MiniVoitz/AES128_SV/CR_AES128.pdf

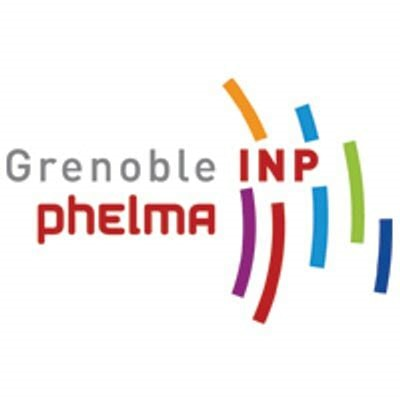
[picture p1: figure]

École Nationale Supérieure de Physique,

# Électronique et Matériaux

## Compte Rendu Mini-Projet AES128

DEVILLARD Hugo - VOITZWINKLER Tom

5 mai 2024

### Table des matières

1 Introduction | 3
2 Architecture | 3
3 RTL | 5
4 Simulation fonctionnelle | 5
5 Synthèse logique | 6
6 Simulation post-synthèse | 7
7 Placement-routage | 8
8 Simulation post-layout | 10
9 Améliorations possibles | 10
10 Conclusion | 10
Bibliographie | 11
Annexes | 11

PHELMA | AES128

### 1 Introduction

Le chiffrement est un élément crucial de la sécurité des données dans de nombreux domaines. L’algorithme de chiffrement avancé AES (Advanced Encryption Standard) est devenu l’un des algorithmes les plus utilisés pour assurer la confidentialité et la sécurité des données. Dans ce rapport, nous présentons notre compte rendu de mini-projet portant sur l’implémentation matérielle de l’algorithme de chiffrement AES128.

L’objectif de ce projet était de concevoir et de simuler une architecture matérielle efficace et optimisée pour le chiffrement et le déchiffrement de données selon la norme AES128. Nous avons choisi de développer cette architecture en utilisant le langage de description matériel SystemVerilog et nous avons réalisé plusieurs étapes allant de la spécification de l’algorithme à la simulation post-layout.

### 2 Architecture

Pour notre architecture nous avons choisi d’utiliser le standard AES128 défini dans [3]. L’algorithme de chiffrement se compose de deux parties principales :

- La génération des clés successives (RoundKey) à partir de la clé initiale : KeyExpansion
- Les différentes étapes du processus de chiffrement : SubBytes, ShiftRows, MixColumns et AddRound-Key. Le standard prévoit de faire 10 tours de boucle (RoundBlock) dans le cas d’AES128.

Le message et la clé sont représentés sous la forme d’une matrice 4x4 avec 16 coefficients qui représentent chacun 8 bits.
Détail de chaque bloc :
- SubBytes : Ce bloc permet de substituer des groupes de 8 bits selon la matrice définie dans le standard.
Nous fournissons en annexe la table utilisée pour la substitution.

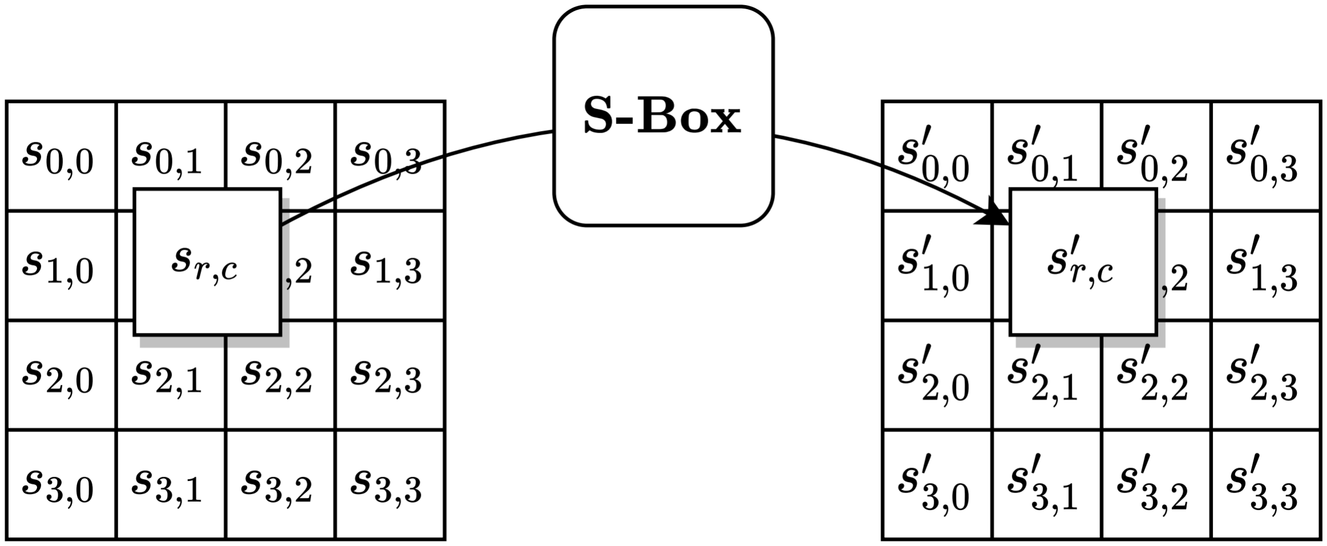
[picture p2: figure]

FIGURE 1 – Illustration de SubBytes

- ShiftRows : Permet d’effectuer une permutation circulaire sur une ligne de la matrice.

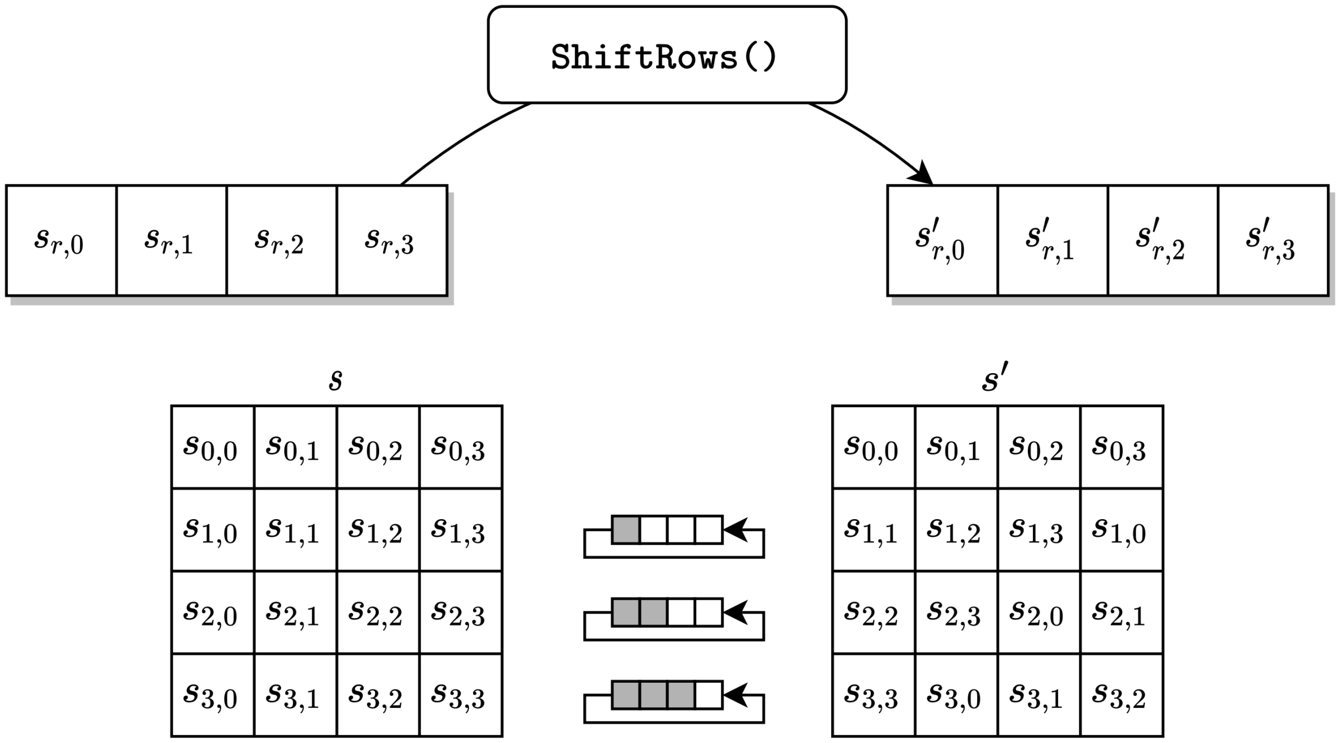
[picture p3: figure]

FIGURE 2 – Illustration de ShiftRows

La première ligne ne subit pas de permutation, la deuxième subit une seule permutation, la troisième deux et la dernière trois.

- MixColumns : Chaque colonne de la matrice est multipliée par une autre matrice qui contient les coefficients d’un polynôme dans le domaine de Galois.

Il est intéressant de noter ici que l’on effectue des multiplications modulaires ainsi lorsque l’on multiplie un coefficient par 2, cela revient à faire l’opération suivante : Soit x un coefficient de la matrice initiale.

- Si le bit de poids fort est 1 alors : le résultat de la multiplication par 2 est ((x « 1) XOR 00011011)
- Sinon le résultat est x « 1

De plus, multiplier par 3 revient à multiplier par 2 et réaliser un XOR avec la valeur initiale.

FIGURE 3 – Multiplication d’une colonne par le polynôme de Galois correspondant

- AddRoundKey : consiste en un XOR entre la matrice en cours et la RoundKey (addition dans le domaine de Galois)

3

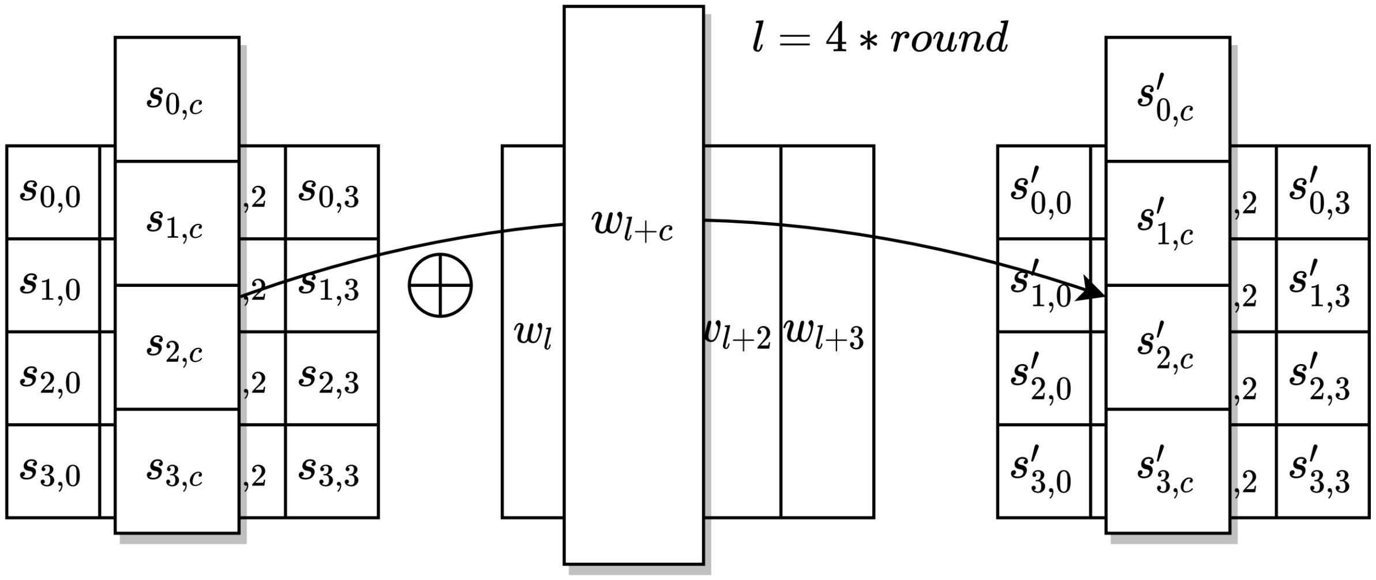
[picture p4: figure]

FIGURE 4 – XOR entre la matrice et la RoundKey

- KeyExpansion : permet de générer les 10 clés successives nécessaires à chaque tour dans la boucle de chiffrement. L’algorithme est fourni en annexe. Le terme Rcon dans l’algorithme correspond à une constante fixée pour chaque round.

### 2.1 Première version : chiffrement

Dans cette première version nous nous sommes concentrés sur la partie chiffrement. Nous obtenons alors l’architecture suivante :

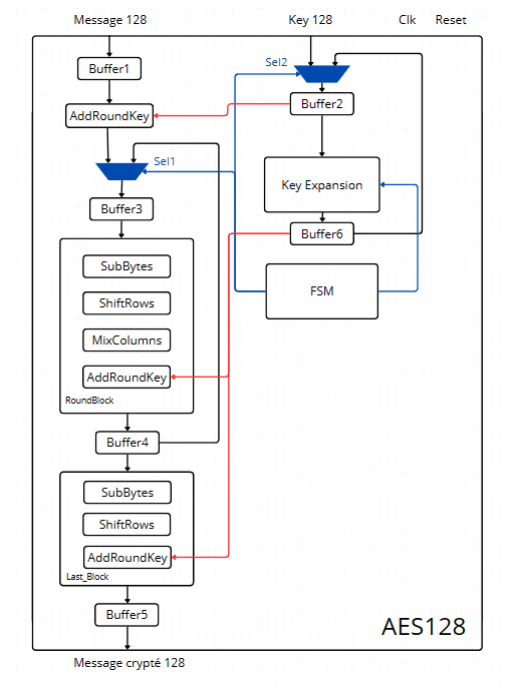
[picture p5: figure]

FIGURE 5 – Architecture choisie pour le chiffrement

Dans ce modèle, nous avons réalisé une approche pipeline en séparant par des registres les différents grands blocs qui composent notre module de chiffrement. De plus, il est à noter que la génération des RoundKey se fait au cours du chiffrement. Ainsi ces clés ne sont pas stockées, ce qui permet de diminuer le nombre de registres.

### 2.2 Deuxième version : Chiffrement et déchif-

frement

Nous avons dans un second temps décidé d’ajouter un module de déchiffrement. Cependant il est n’est plus possible de générer en cours de déchiffrement les Round-Key puisque cela signifierait d’effectuer 10! générations de RoundKey. En effet, nous avons besoin pour le déchiffrement d’avoir accès à la RoundKey numéro 10 en première clé. Cette RoundKey ce génère à partir de la 9

me RoundKey qui elle-même est générée à partir de la 8... La complexité augmente rapidement. C’est pourquoi nous avons choisi de stocker les 11 clés (10 RoundKey + 1 Key) qui permettent le chiffrement et le déchiffrement du message. Le fait de stocker ces clés augmente toutefois le nombre de registres. Nous obtenons alors l’architecture suivante :

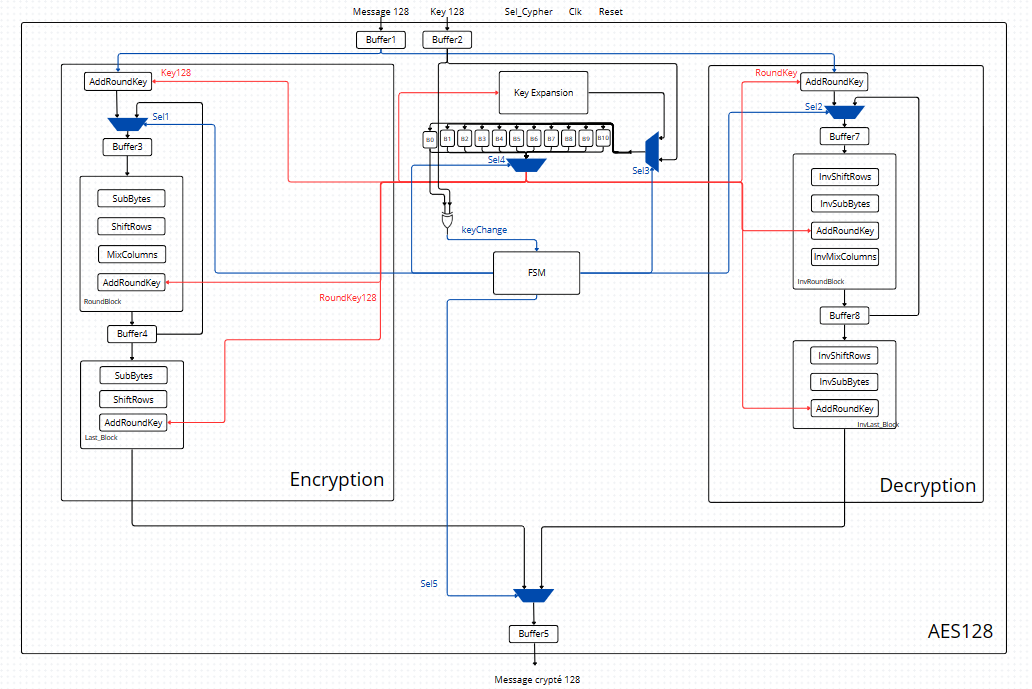
[picture p6: figure]

FIGURE 6 – Architecture choisie qui permet le chiffrement et le déchiffrement

Nous avons de plus ajouté une comparaison entre la clé d’entrée et celle stockée dans le registre nommé B0. Cette comparaison permet de chiffrer/déchiffrer plusieurs messages de suite avec la même clé sans avoir à régénérer toutes les RoundKey.

### 2.3 Troisième version : Module complet avec in-

terface de communication

Comme notre système comportait un grand nombre de pins (128 pour le message, 128 pour la clé, 128 pour le message chiffré et quelques pins de contrôle), il était nécessaire de créer une interface de communication. Nous nous sommes alors inspirés du bus APB [1]. Nous proposons alors une interface de communication permettant d’envoyer et de recevoir les informations par salves de 32 bits à l’aide de quelques signaux de contrôle :

- Initiate : permet de lancer la communication en passant à l’un des états de lecture/écriture.
- Data : Bus de données.

4

- R/W : Permet de choisir si on veut lire ou écrire les données sur les registres du module.
- Address : Permet de choisir si on souhaite écrire le message ou la clé (0 : message, 1 : clé)
- SelCypher : Permet de choisir si on veut chiffrer ou déchiffrer le message envoyé. (1 : chiffrement, 0 : déchiffrement)
- Start : Permet de lancer le calcul. Nous n’avons pas lancé le calcul immédiatement après réception des données pour simplifier notre FSM d’interface.
- CS : Un signal permet de déconnecter le registre de sortie (en état haute impédance) tant que la fsm d’interface n’est pas dans l’état d’envoi du résultat sur le bus.

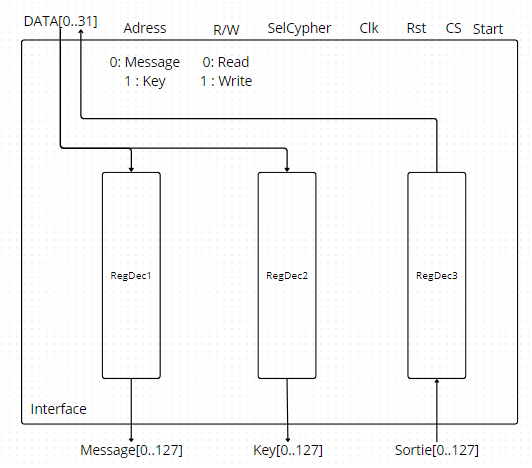
[picture p7: figure]

FIGURE 7 – Interface de communication entre le bus et le module AES

En réalité, dans le coeur de notre circuit, nous avons utilisé deux bus de données data_in et data_out : un pour l’entrée et l’autre pour la sortie ainsi qu’un signal CS qui est relié à chaque plot correspondant au bus. En effet, cela nous permet d’utiliser un plot de type BBT16P qui utilise une porte à trois états pour se déconnecter du bus :

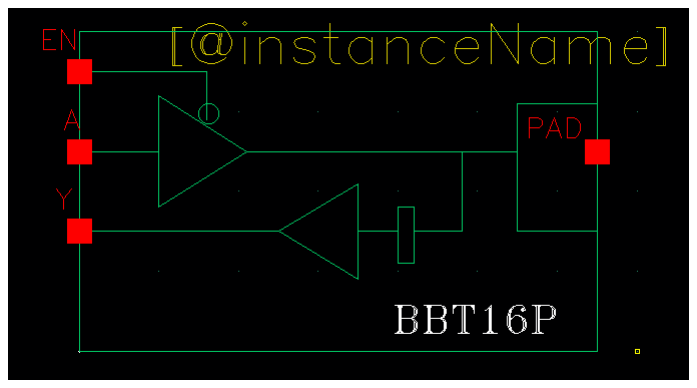
[picture p8: figure]

FIGURE 8 – Vue schematic du plot BBT16P

Le schéma complet de l’architecture réalisée est présent en annexe.

Avec cette architecture, nous nous attendons donc à retrouver :

- Les registres de stockage des RoundKey : 11 × 128 = 1408 registres
- Les registres de l’interface : 3×128 = 384 registres
- Les registres présents entre les étapes de l’algorithme : 7 × 128 = 896 registres
- Les registres d’états des deux fsm : 7 registres.

Au total, notre architecture compte donc : 2695 registres.

### 3 RTL

Nous avons codé notre module de chiffrement en System Verilog. L’ensemble de notre code ainsi que les testbench est disponible sur le répertoire Github Cliquer ICI. (https://github.com/MiniVoitz/AES128_SV) Nous fournissons également les fichiers .do permettant d’avoir un affichage plus lisible des signaux sur Model-Sim. Il est à noter que nous avons vérifié toutes les erreurs de syntaxe ainsi que les potentiels latch inference à l’aide du module LINT de Spyglass. Le répertoire git présente plusieurs branches avec le code pour la simulation fonctionnelle, le code après synthèse et le code après placement-routage.

### 4 Simulation fonctionnelle

On réalise ensuite, par l’intermédiaire de ModelSim, des simulations de chaque sous-bloc de notre module ainsi que de notre module entier. Là encore les testbenchs sont présents sur le répertoire Github Cliquer ICI. (https://github.com/MiniVoitz/AES128_SV)
La complexité de l’algorithme fait que si l’un des sous blocs crée un bit erroné le message crypté final aura presque 50% de bits erroné. Un test validé signifie qu’il est peu probable que notre module fonctionne par chance. De plus de nombreux logiciels qui permettent de chiffrer/déchiffrer un message sont disponibles en ligne, ce qui nous a permis de tester aisément le bon fonctionnement de notre module.
Prenons par exemple la simulation de notre bloc au complet et testons de chiffrer puis de déchiffrer le message :

5

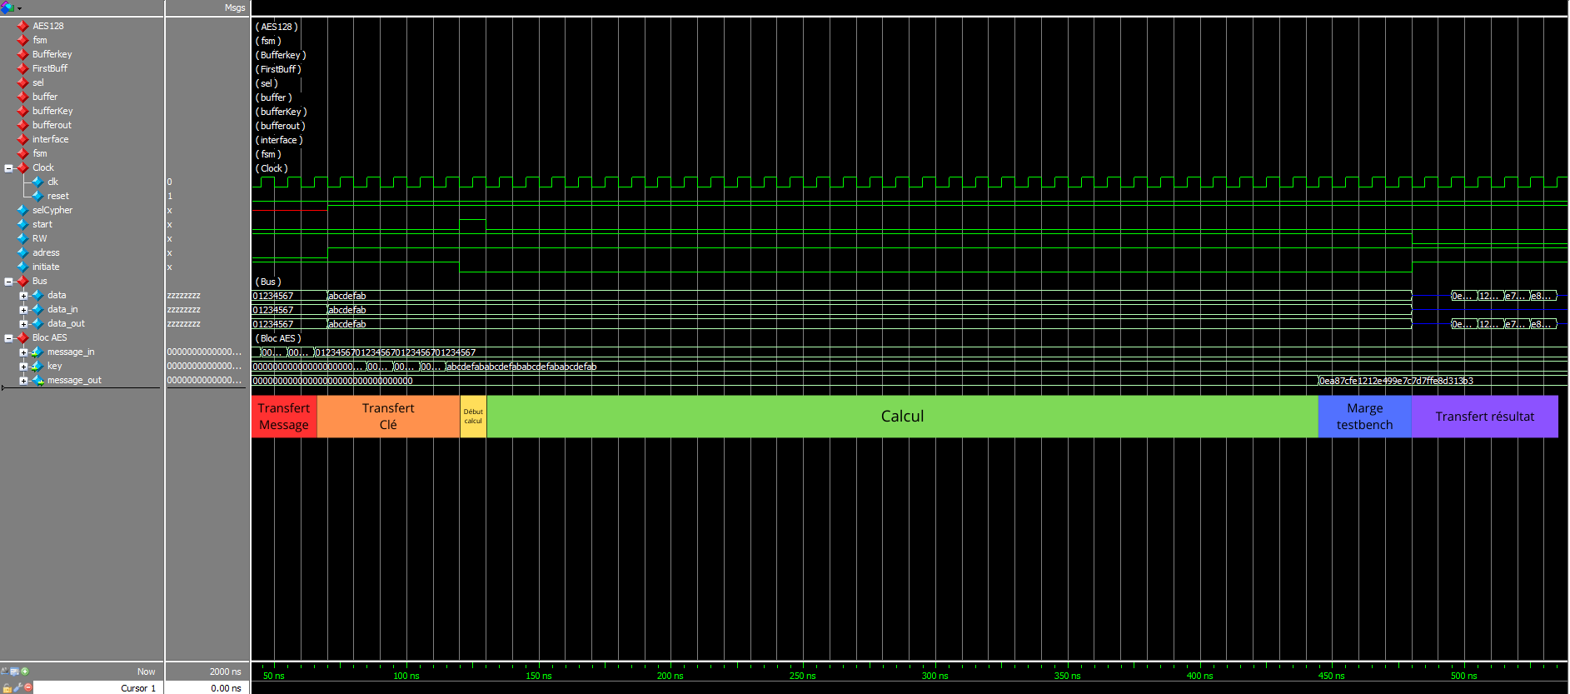
[picture p9: figure]

FIGURE 9 – Chiffrement d’un message

Le résultat est bien celui qui est attendu, comme le montre le calculateur utilisant l’algorithme que l’on cherche à implémenter :

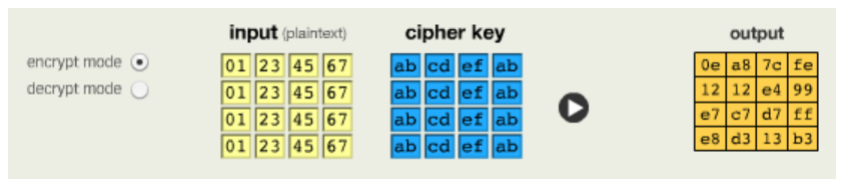
[picture p10: figure]

FIGURE 10 – Résultat du chiffrement

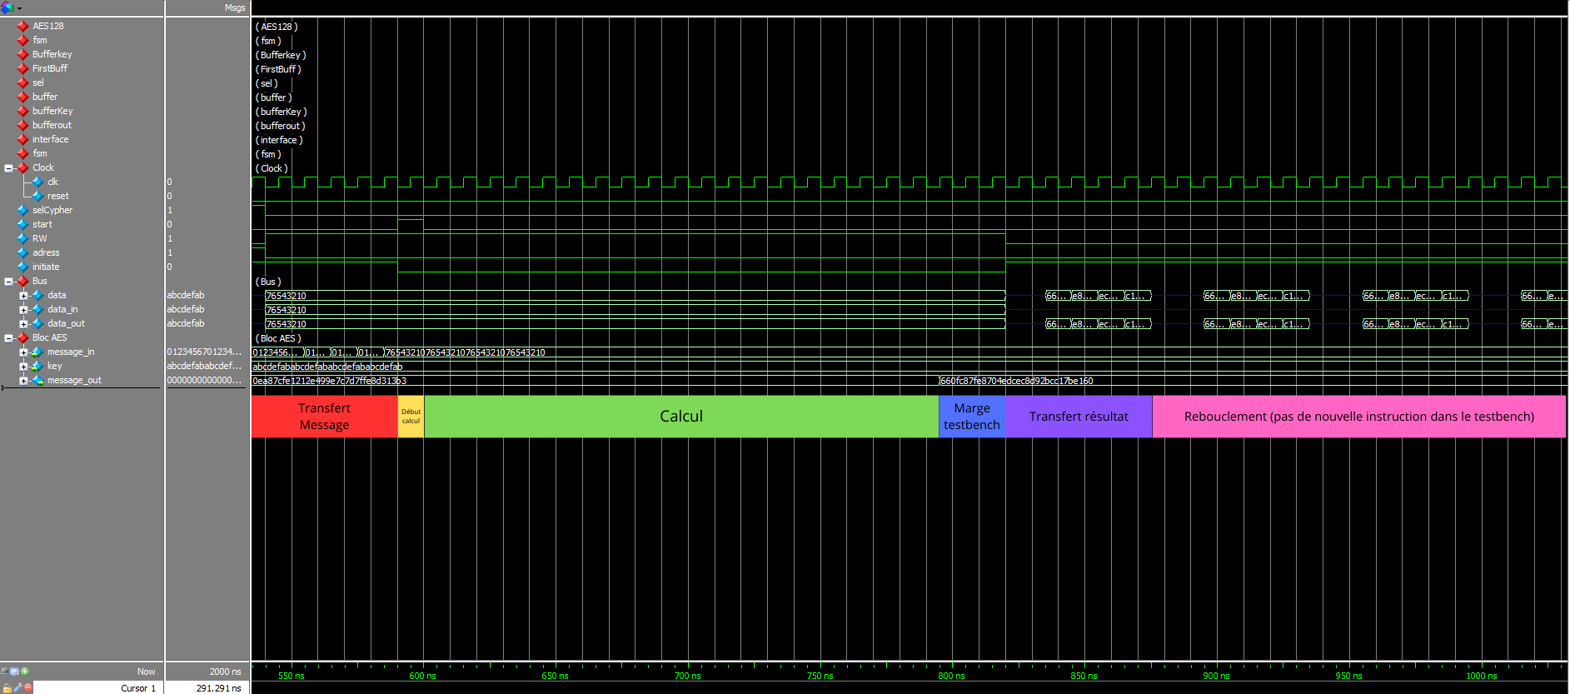
[picture p11: figure]

FIGURE 11 – Déchiffrement d’un message

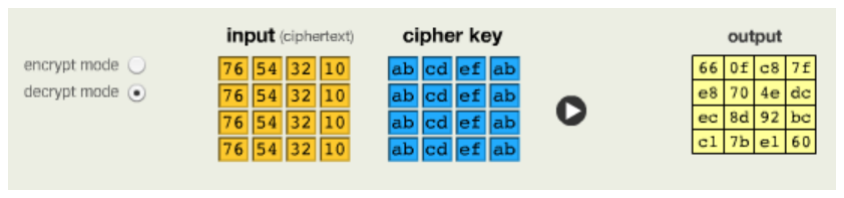
[picture p12: figure]

FIGURE 12 – Résultat du déchiffrement

On note qu’il n’a pas été nécessaire de retransmettre la clé de chiffrement entre les deux étapes. Cette fonctionnalité nous a paru pertinente du fait que AES128 est un chiffrement symétrique donc la clé est la même pour le chiffrement et le déchiffrement. On peut ainsi éviter le chemin critique imposé par la génération des RoundKey et ainsi gagner du temps sur la phase de calcul.

### 5 Synthèse logique

On cherche à présent à traduire la description fonctionnelle du circuit en une représentation logique qui sera implémentée sous forme de portes logiques et de bascules génériques. Pour cela, nous utilisons DesignVision. L’objectif de cette partie est dans un premier temps, la vérification de la cohérence de notre module i.e. s’assurer que la conception répond bien aux spécifications fonctionnelles du circuit. Puis nous nous intéresserons à l’étude du chemin critique, la détermination d’une fréquence d’horloge valide, l’estimation de la consommation et de la surface. De plus cette synthèse nous permet de vérifier une seconde fois la bonne réalisation de notre module en étudiant le nombre de registres alloués. Comme il n’y avait pas de contraintes sur les performances du circuit final, nous choisissons une approche qui n’optimise aucun paramètre en particulier.

### 5.1 Étude du chemin critique

En testant les limites de notre module on remarque que pour une fréquence d’horloge idéale de 8 ns on obtient un bon fonctionnement du circuit si la réponse de chaque bloc est inférieur à 7.82 ns, ce qui est tout juste le cas :

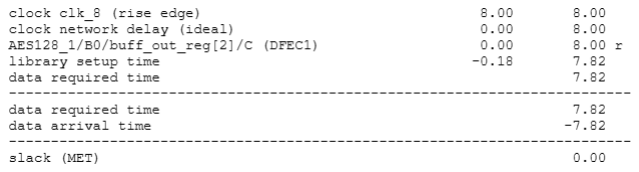
[picture p13: figure]

FIGURE 13 – Rapport du chemin critique par Design Vision pour TCLK = 8ns

Le logiciel de synthèse permet également d’obtenir une répartition des chemins prenant le plus de temps dans le circuit. Pour cela, il additionne le temps propre à chaque porte logique pour chaque chemin possible et en déduit ainsi le chemin critique.
Puisque nous n’avions pas de cahier des charges nous avons choisi une période d’horloge de 10 ns pour les prochaines études ainsi que pour la génération de la netlist. Dans ce cas nous observons la répartition suivante des chemins critiques :

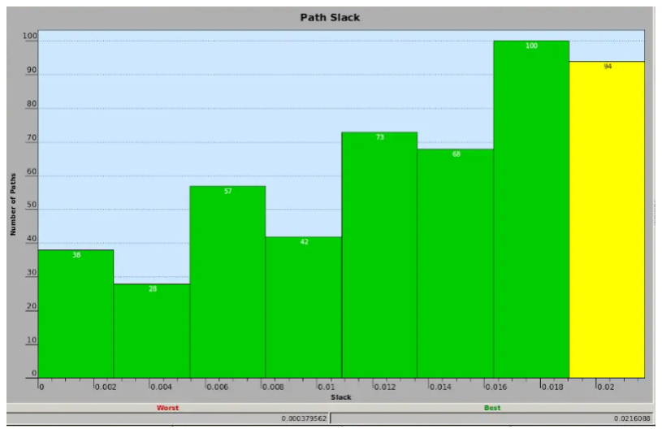
[picture p14: figure]

FIGURE 14 – Répartition des différents temps de réponse

Nous remarquons alors que le chemin critique se trouve lors de la génération des RoundKey.

6

Il pourrait être intéressant de comparer le temps lié au passage dans RoundKey et de le comparer avec l’écart obtenu lors de la simulation avec réutilisation de la clé pour voir si notre architecture permet effectivement de gagner du temps en stockant toutes les clés successives.

### 5.2 Étude de la surface

Pour ce qui est de l’étude de la surface occupée par notre circuit, nous avons utilisé les fonctionnalités de synthèse de Design Vision pour estimer la taille occupée par notre conception sur la puce. Cette surface n’est pas représentative du circuit final puisque la surface estimée par DesignVision ne tient pas compte des contraintes de placement routage et de géométrie mais se contente d’additionner les surfaces de toutes les portes logiques utilisées. À une fréquence d’horloge de 10 ns, la synthèse nous indique que la surface totale occupée par notre circuit est d’environ 4.8mm²

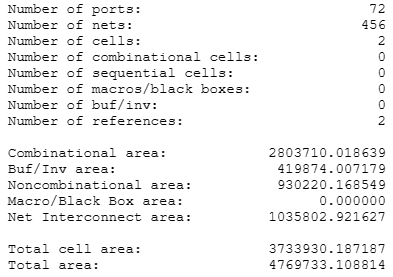
[picture p15: figure]

FIGURE 15 – Rapport de la surface totale de la synthèse

FIGURE 16 – Détail de la surface du module complet

On remarque que la surface est avant tout limitée par la présence d’un grand nombre de registres, à l’aide des des outils de DesignVision, nous avons pu vérifier que la synthèse avait bien le même nombre de registres que notre architecture.

### 5.3 Étude de la consommation

Finalement on s’intéresse à la consommation de notre circuit. Design Vision nous permet d’obtenir une estimation de la puissance de notre module. Le logiciel additionne ainsi les consommations statique et dynamique de chaque porte logique mais ne prend pas en compte les éléments ajoutés lors du placement routage comme la consommation de l’arbre d’horloge, des interconnexions, des plots et des fillers entre les cellules. Un extrait du rapport est disponible ci-dessous.

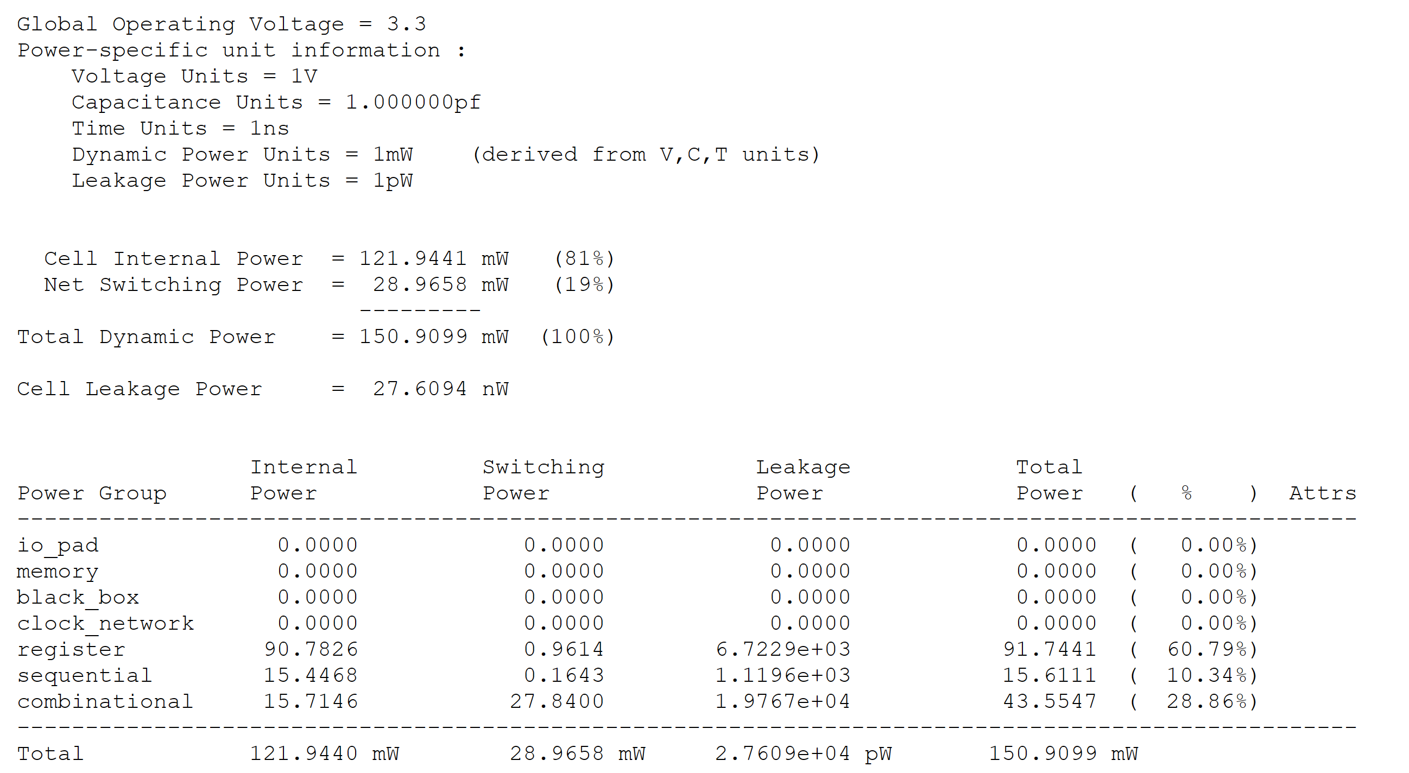
[picture p16: figure]

FIGURE 17 – Estimation de la consommation

A nouveau nous n’avions pas de cahier des charges, cette étude nous permet donc uniquement d’obtenir une idée de la consommation. Nous n’avons pas cherché à optimiser ce paramètre. On peut toutefois noter que la majeur partie de la consommation est liée aux registres utilisés : si on veut réduire la puissance consommée, il faut ainsi réduire le nombre de registres.

A la fin de la synthèse logique nous disposons d’une netlist verilog contenant les portes logiques génériques utilisées pour notre circuit ainsi qu’une estimation du délai dans chaque chemin réalisé par STA (static timing analysis) dans un fichier sdf.

### 6 Simulation post-synthèse

Après avoir effectué la synthèse logique, qui consiste à traduire la description fonctionnelle du circuit en une représentation logique, la simulation post-synthèse permet de vérifier le comportement fonctionnel et chronologique du circuit synthétisé.

Le testbench nommé : Puce_sans_plot_tb.sv permet la vérification du bon fonctionnement de notre module de chiffrement après la synthèse logique.

Nous illustrons ici deux exemples prenant en compte le fichier SDF (si on zoomait sur la figure, on pourrait observer les décalages temporels induits par les retards dans les portes logiques) :

7

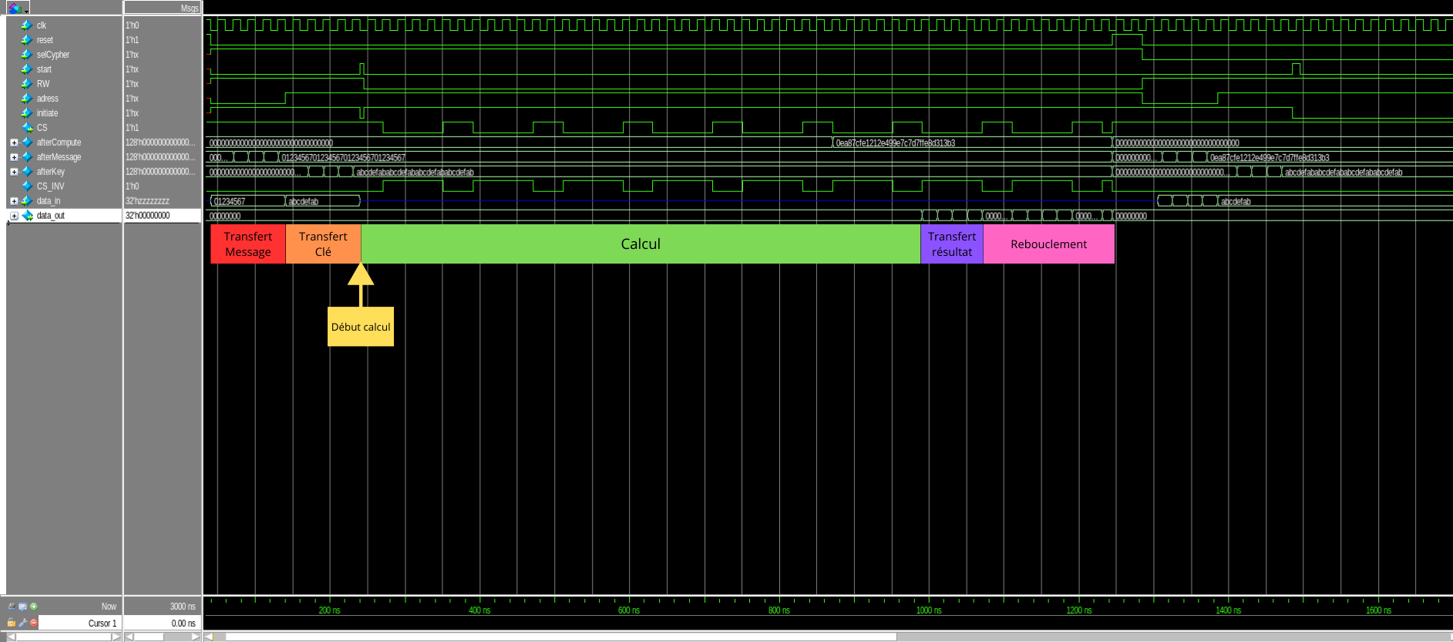
[picture p17: figure]

FIGURE 18 – Simulation d’un chiffrement post-Synthèse avec prise en compte du fichier SDF

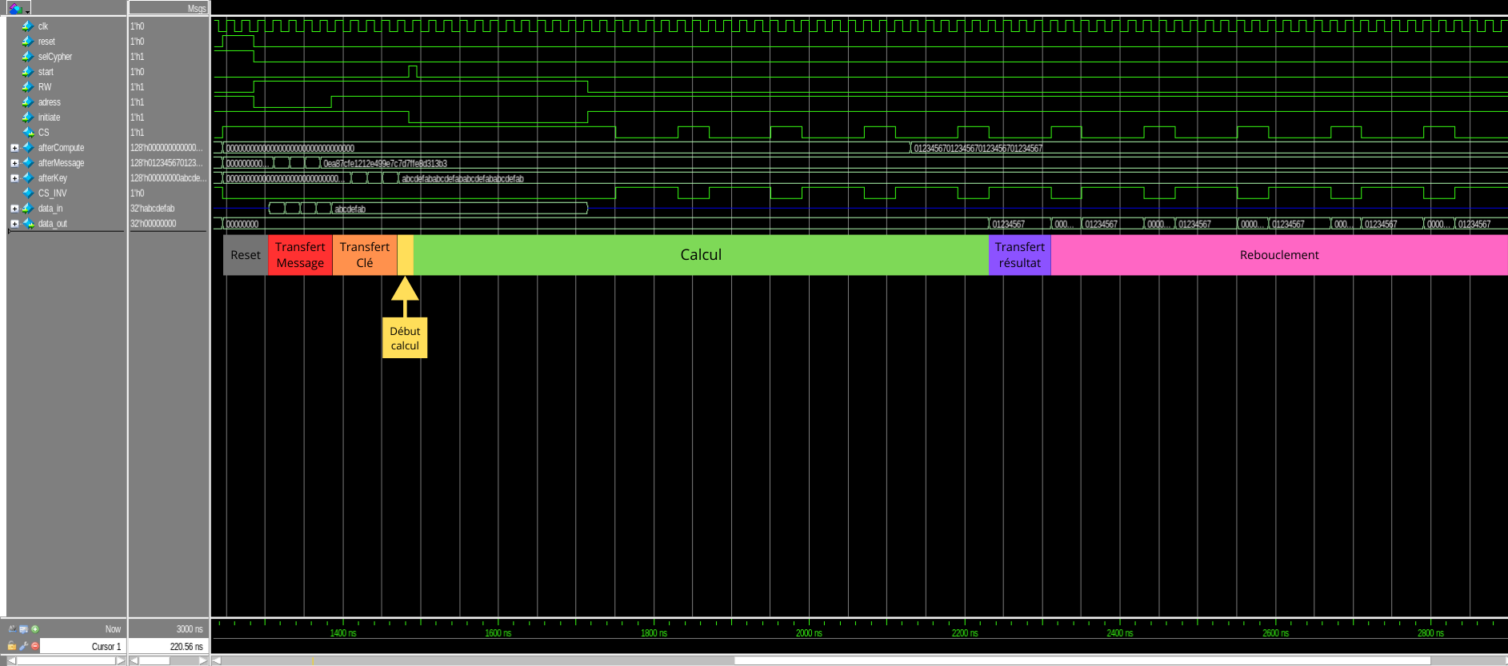
[picture p18: figure]

FIGURE 19 – Déchiffrement post-Synthèse avec fichier SDF

Nous avons vérifié dans les deux cas la valeur retournée par notre module à l’aide du calculateur cité en bibliographie. La phase de rebouclement est simplement due à notre testbench qui permet de renvoyer le plus tôt possible la valeur calculée.

### 7 Placement-routage

Nous avons ensuite procédé à l’étape de Placement-Routage de notre circuit en utilisant l’outil Innovus. Cette étape consiste à mapper la conception logique du circuit sur la surface physique de la puce, en assignant des positions physiques à chaque élément du circuit. C’est ici que l’on définit les contraintes physiques de notre circuit :

- Position des plots
- Ring et Stripes pour l’alimentation
- Définition de l’arbre d’horloge
- Choix de la taille du coeur

Pour simplifier la conception, nous avons réalisé les étapes à l’aide de l’interface graphique puis nous avons copié les commandes qui nous convenaient dans le script init.tcl d’Innovus.
Comme indiqué dans le TP Filtre, il faut prendre des pistes de l’ordre de 1 µm par mA pour les rings d’alimentation : or d’après le rapport DesignVision, notre circuit consomme presque 50 mA, c’est pourquoi nous avons choisi des pistes de 50 µm de large.
Nous avons choisi de mettre 5 stripes pour éviter les zones de chutes de tension dues aux pertes linéiques.

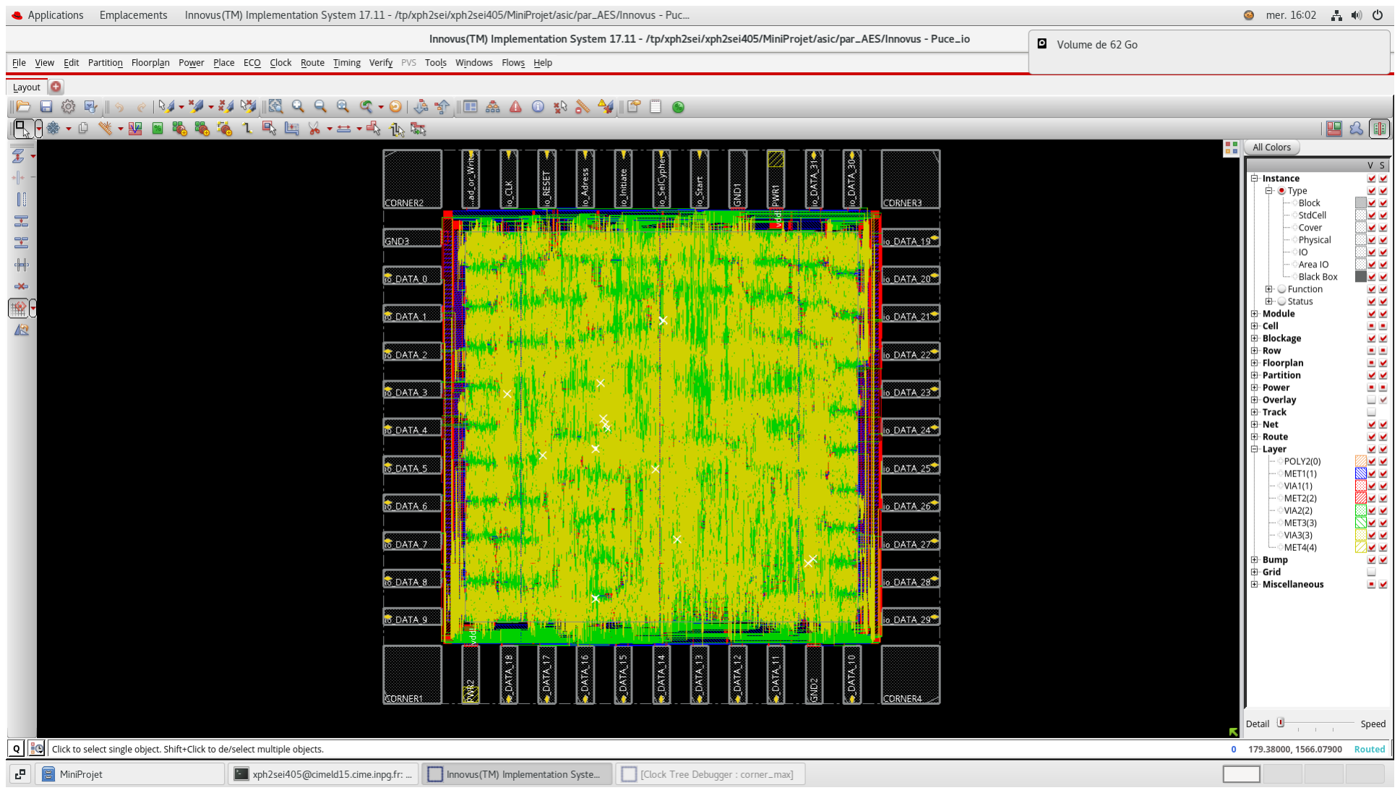
[picture p19: figure]

FIGURE 20 – Layout final après placement-routage

Il reste quelques erreurs liées aux contraintes du fondeur mais qui pourraient être résolues.

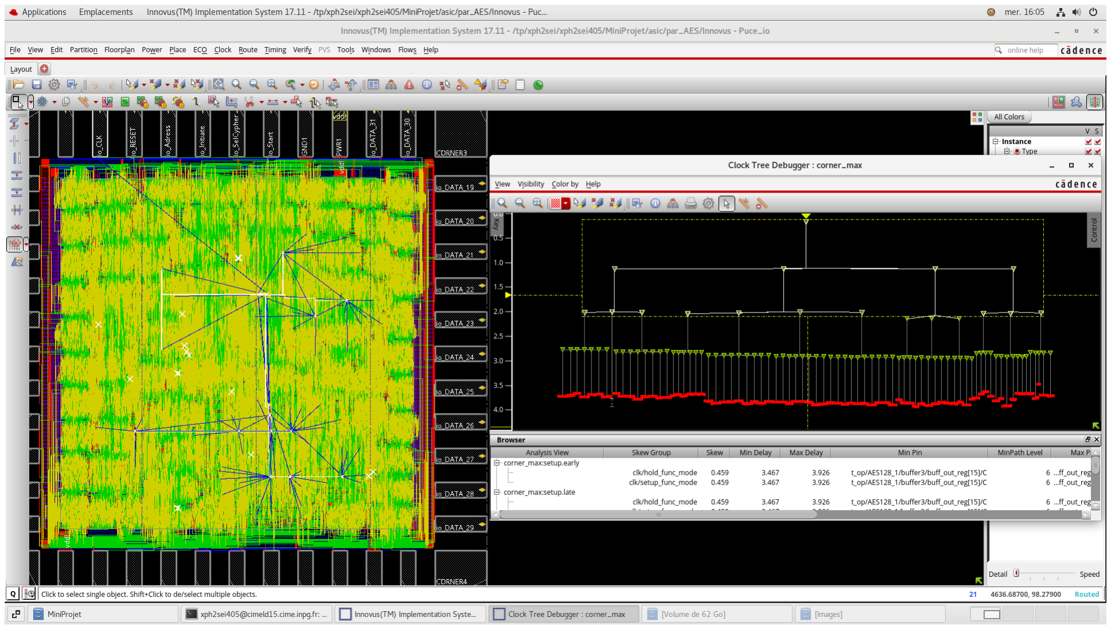
[picture p20: figure]

FIGURE 21 – Emplacement de l’arbre d’horloge

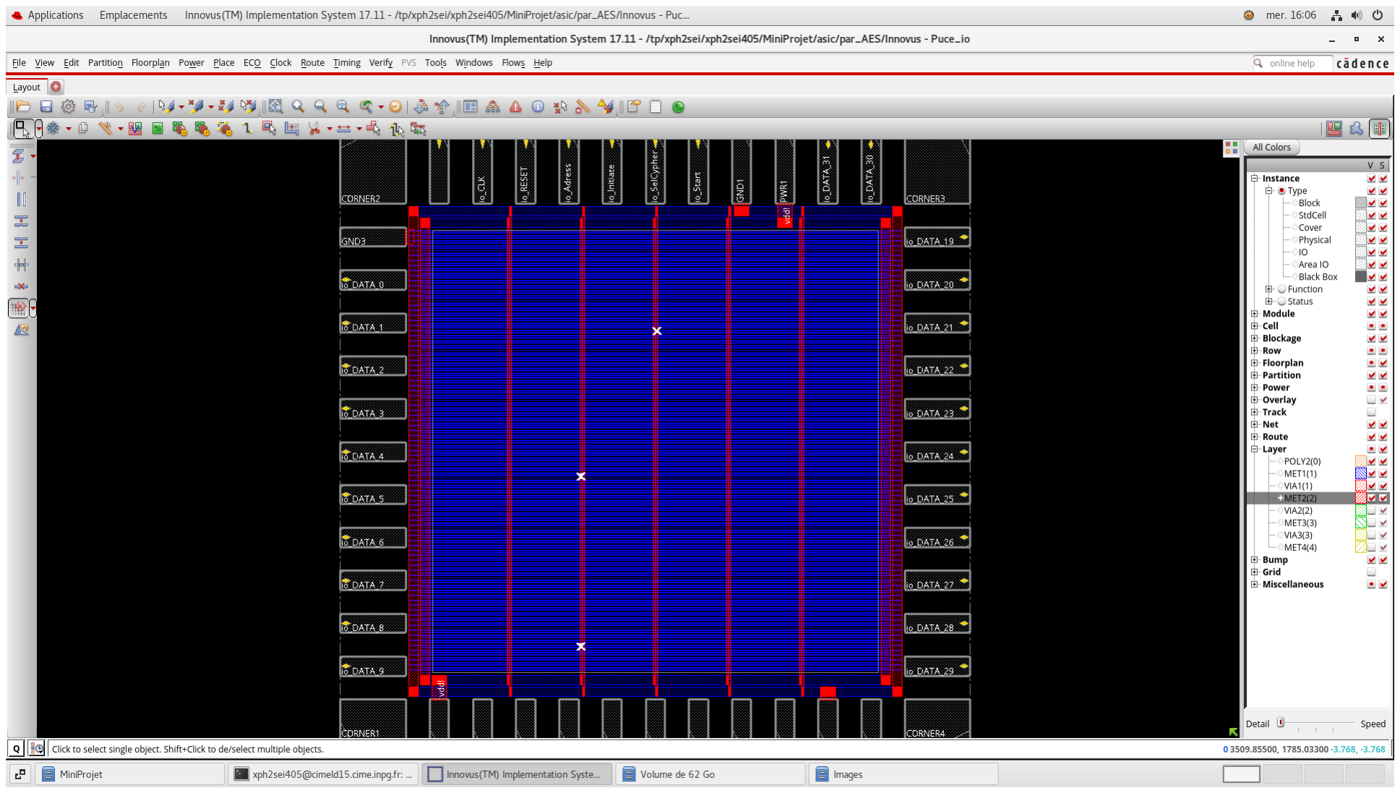
[picture p21: figure]

FIGURE 22 – Rings et Stripes du design

8

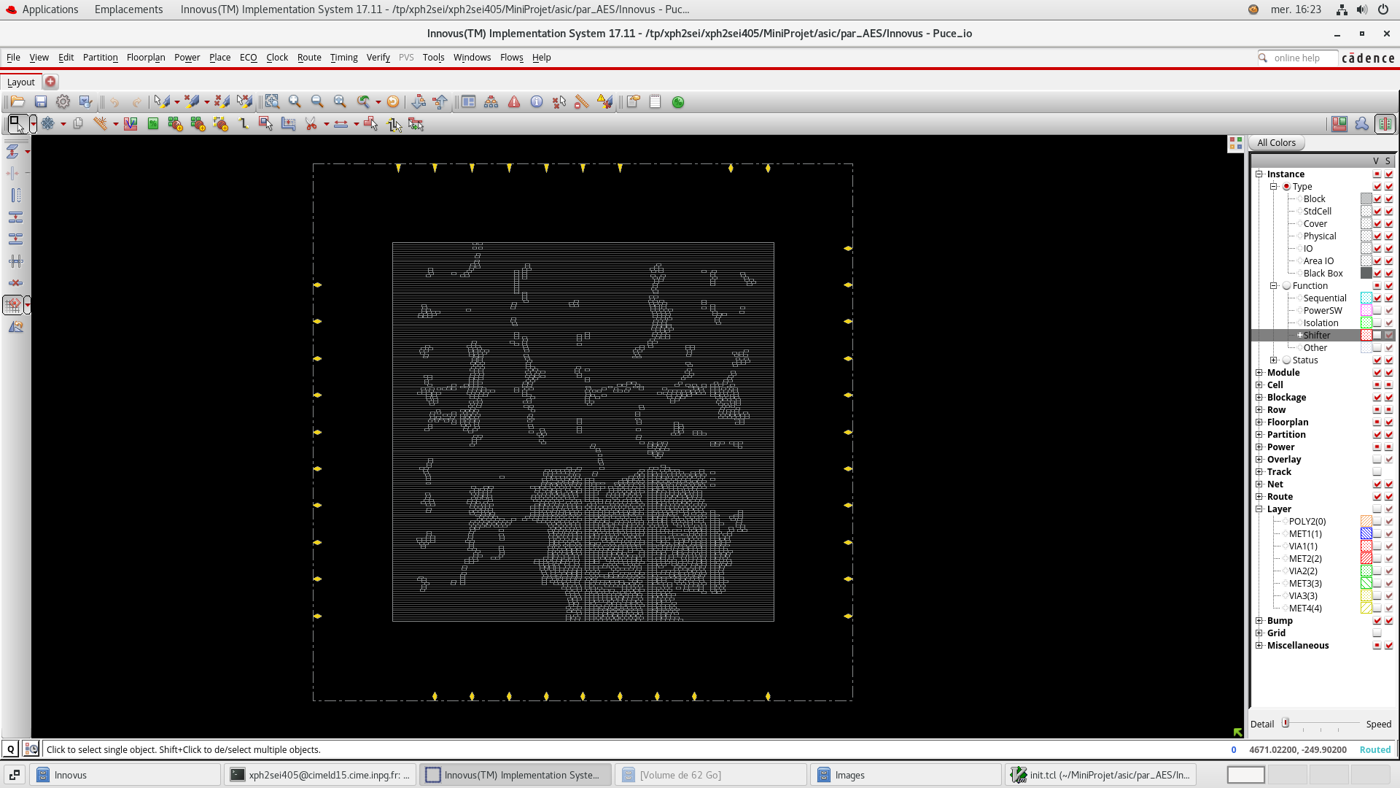
[picture p22: figure]

FIGURE 23 – Espace occupé par les registres dans le coeur

Une grande partie de la surface est occupée par les registres comme ce qui avait été prévu par DesignVision. On peut notre que le logiciel de placement-routage a placé tous les registres qui concernent le traitement des données dans la même région même si ceux-ci sont dans des unités différentes dans le code Verilog initial.

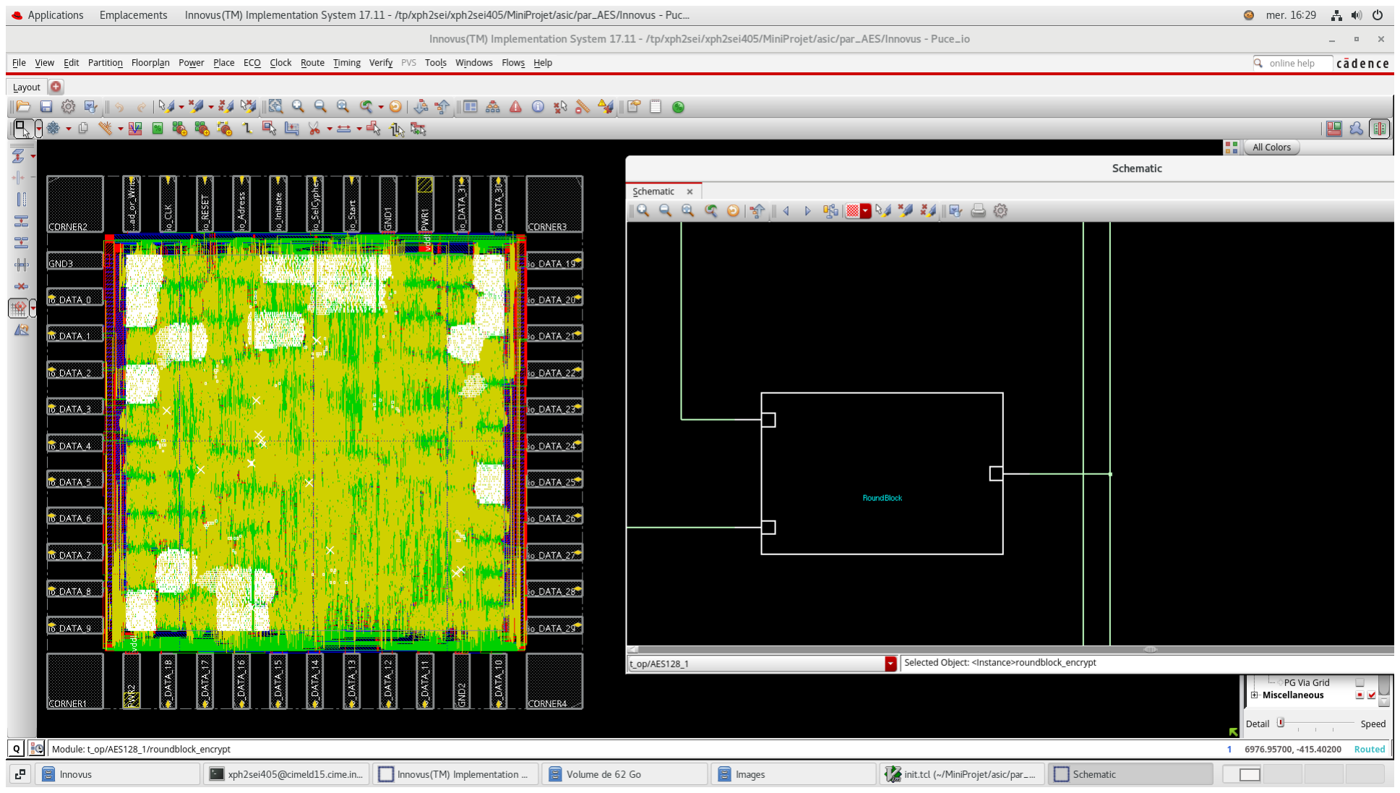
[picture p23: figure]

FIGURE 24 – Espace occupé par le bloc RoundBlock

La logique combinatoire représente au final une partie très limitée du design.

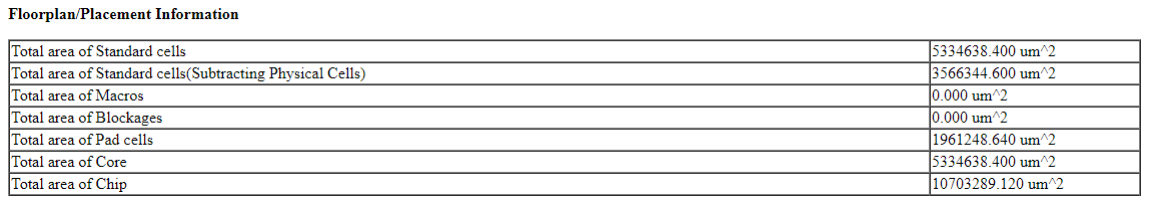
[picture p24: figure]

FIGURE 25 – Surface design après placement-routage

On obtient une surface occupée par les cellules beaucoup plus grande que lors de la synthèse, en effet, les contraintes de placement routage ajoutent une surface supplémentaire liée aux fillers et à l’arbre d’horloge par exemple.

FIGURE 26 – Répartition des liaisons sur les niveaux de métallisation

La majorité des liaisons se fait sur le niveau MET1, ce qui signifie que le circuit aura moins de pertes liées aux interconnexions. En effet, plus on utilise des niveaux de métallisation élevés, plus les pertes linéiques augmentent.

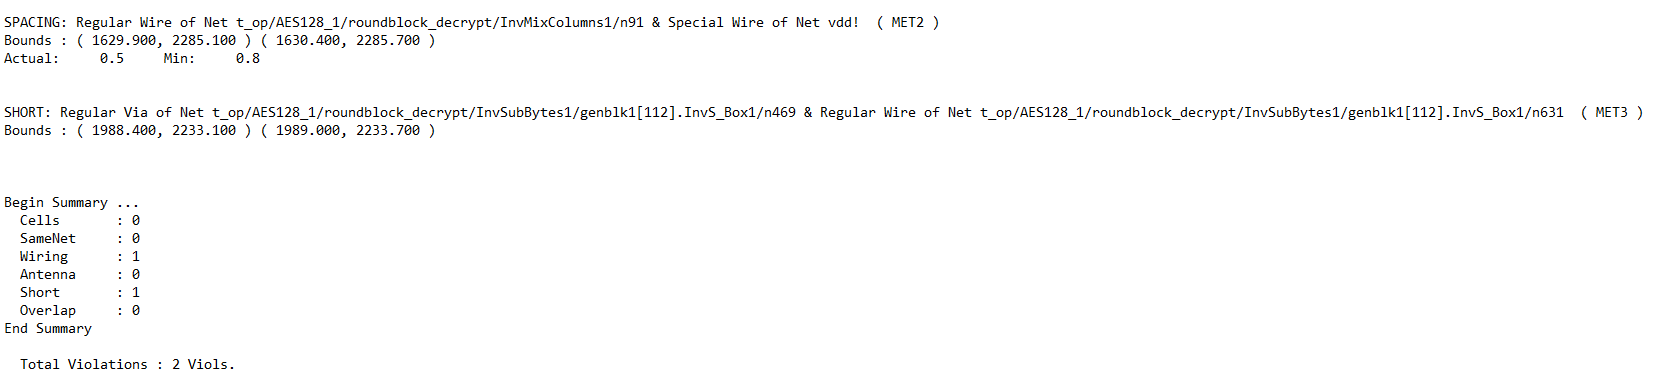
[picture p25: figure]

FIGURE 27 – Violations des règles du fondeur

Il reste quelques violations des règles du fondeur qu’il serait possible de régler en relançant le placement-routage avec de nouveaux paramètres ou en modifiant manuellement le layout.

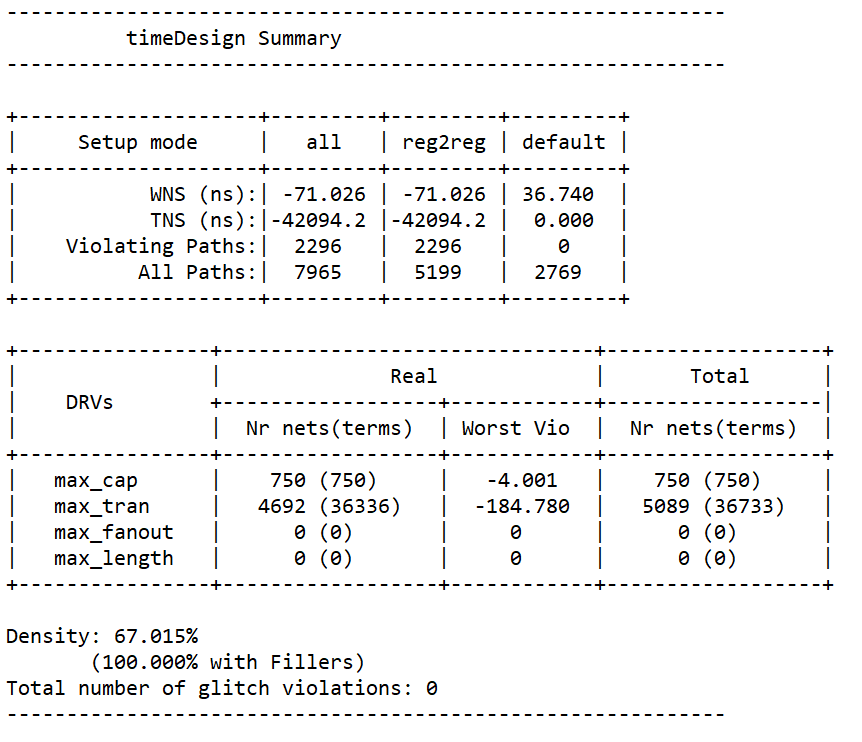
[picture p26: figure]

FIGURE 28 – Rapport de timing après placement-routage

L’analyse temporelle ne trouve pas de violations de timing qui pourraient causer des glitchs dans le circuit. Notre circuit est core-limited autrement dit, l’espace occupé par le coeur (avec le paramètre de densité de 0.7 choisi) ne permet pas de tenir au sein de la couronne de plots si ceux-ci ne sont pas écartés.
Après cette étape, nous disposons du fichier GDS qui contient le layout du design, d’une netlist Verilog qui contient les portes utilisées dans le layout final ainsi que

9

d’un nouveau fichier SDF qui prend en compte les délais dans les interconnexions après analyse des parasites RC.

### 8 Simulation post-layout

Après avoir effectué le placement et le routage nous effectuons une simulation post-layout. Cette dernière permet de vérifier le comportement fonctionnel et chronologique du circuit après qu’il a été physiquement implémenté sur la puce. Nous avons notamment récupérer le fichier Standard Delay Format (sdf) qui contient des informations sur les délais de propagation, les délais d’arrivée, les contraintes de timing, les informations sur les horloges, les charges capacitives des lignes de signal etc... Le testbench nommé : Puce_io_after_rout_tb permet la vérification du bon fonctionnement de notre module de chiffrement après le placement routage.

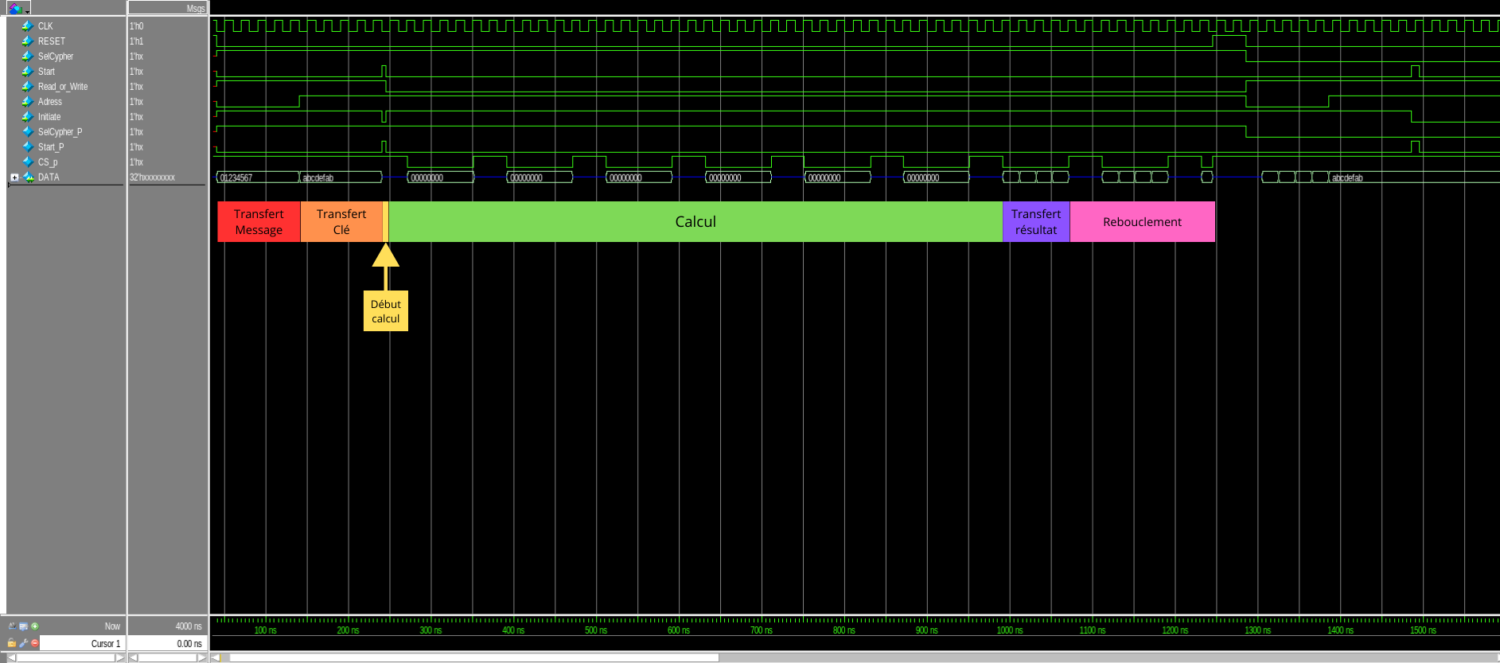
[picture p27: figure]

FIGURE 29 – Chiffrement post-Layout avec SDF

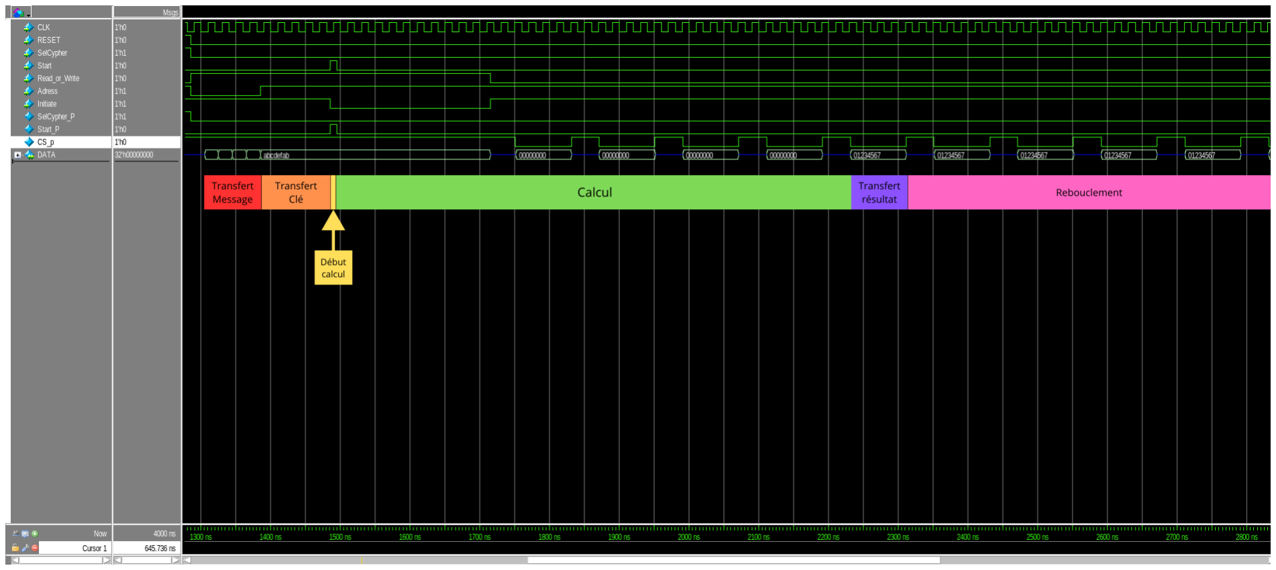
[picture p28: figure]

FIGURE 30 – Dechiffrement post-Layout avec SDF

Nous obtenons encore une fois le bon résultat en vérifiant avec le calculteur fourni en bibliographie.

### 9 Améliorations possibles

Étant limités par le temps, notre projet n’est pas optimisé et encore moins prêt pour une fabrication éventuelle. C’est pourquoi nous analysons dans cette partie une liste de points que nous aurions aimé améliorer.

- Diminution du nombre de SBox : nous avons remarqué lors de la synthèse logique que nous utilisions à deux reprises le module SubBytes, une fois dans RoundBlock et une fois dans LastBlock. Sub-Bytes génère 16 S_Box. Nous aurions pu optimiser d’avantage notre puce en réutilisant les 16 S_Box de Roundblock dans le module LastRound. Comme notre puce contient le cryptage et le decryptage cela aurait permis d’économiser 32 S_Box. Ce qui représente 2 × 16 × 16 × 8 = 1024 registres.
- Diminution du nombre de registres : Nous pouvons encore réduire le nombre de registres utilisés, par exemple en réunissant les blocs de calcul et d’interface, ce qui permettrait d’économiser les registres d’interface. On pourrait par ailleurs penser à une architecture qui ne stocke pas les roundKey.
- Sécurité : Notre projet n’avait pas pour objectif la conception d’une puce sécurisée, ce qui est pourtant un attendu d’une puce cryptographique. En effet, il est très certainement possible de retrouver la clé secrète utilisée pour les calculs que ce soit à l’aide d’une attaque physique ou par canaux auxiliaires.
- Testbenchs : Les testbenchs ont été réalisés dans des conditions favorables même si une erreur dans le chiffrement provoque 50 % d’erreur en sortie de l’algorithme selon le standard, il pourrait être intéressant de faire des testbenchs à validation automatique (scripts et non vérification visuelle) pour s’assurer du fonctionnement de notre système.
- Vérification : partie du flot que nous n’avons pas réalisé mais qui constituerait une partie importante du temps alloué au projet si on devait la réaliser.
- Chaîne de test : Insertion de scan chains et d’autres éléments pour tester notre circuit après fabrication.
- Modification de la fsm d’interface : Nous avons fait une fsm d’interface très simplifiée qui mériterait d’être adaptée à un bus de communication standard type APB pour que notre projet soit utilisable en condition réelle. De plus, il serait intéressant de réaliser un meilleur système de lancement des calculs puisque celui-ci se réalise à l’aide d’un reset de la fsm du bloc de calcul provoqué par l’utilisateur.

### 10 Conclusion

Ce projet nous a permis de mettre en application tous les concepts appris cette année notamment ceux du flot de conception. Le fait d’être en autonomie permet de progresser rapidement sur la prise en main des outils et d’acquérir des connaissances durables dans notre domaine d’activité.

10

### Bibliographie

[1] AMBA APB Protocol Specification. ARM. 2010. URL : https : / / developer . arm . com / documentation/ihi0024/c/. (https://developer.arm.com/documentation/ihi0024/c/)
[2] Lubos GASPAR Viktor FISCHER Florent BER-NARD Lilian BOSSUET Pascal COTRET. A Novel Concept of Crypto-processor with Secured Key Management. International Conference on Reconfigurable Computing. 2010. URL : https://hal.
science/hal-00750348/document. (https://hal.science/hal-00750348/document)
[3] National Institute of STANDARDS et TECHNOLOGY. Advanced Encryption Standard. Federal Information Processing Standards Publication (FIPS). 2023.
DOI : 10.6028/NIST.FIPS.197-upd1. (https://doi.org/10.6028/NIST.FIPS.197-upd1)
[4] FORMAESTSTUDIO. Rijndael (AES) Animation. URL : https : / / formaestudio . com / portfolio/aes-animation/. (https://formaestudio.com/portfolio/aes-animation/)

### Annexes

Table de conversion pour le bloc SubBytes

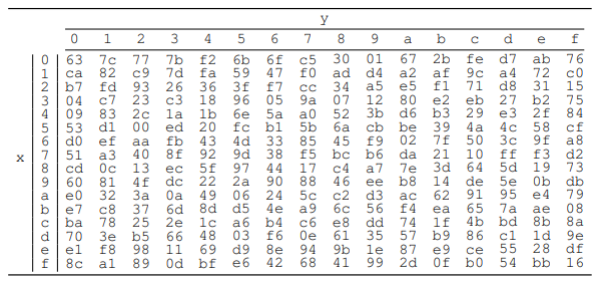
[picture p29: figure]

FIGURE 31 – Table utilisée pour la substitution dans le bloc SubBytes où xy est l’octet noté en hexadécimal

Tableau des constantes de Round

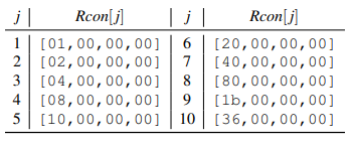
[picture p30: figure]

FIGURE 32 – Tableau des constantes Rcon

11

Schéma complet de l’ASIC

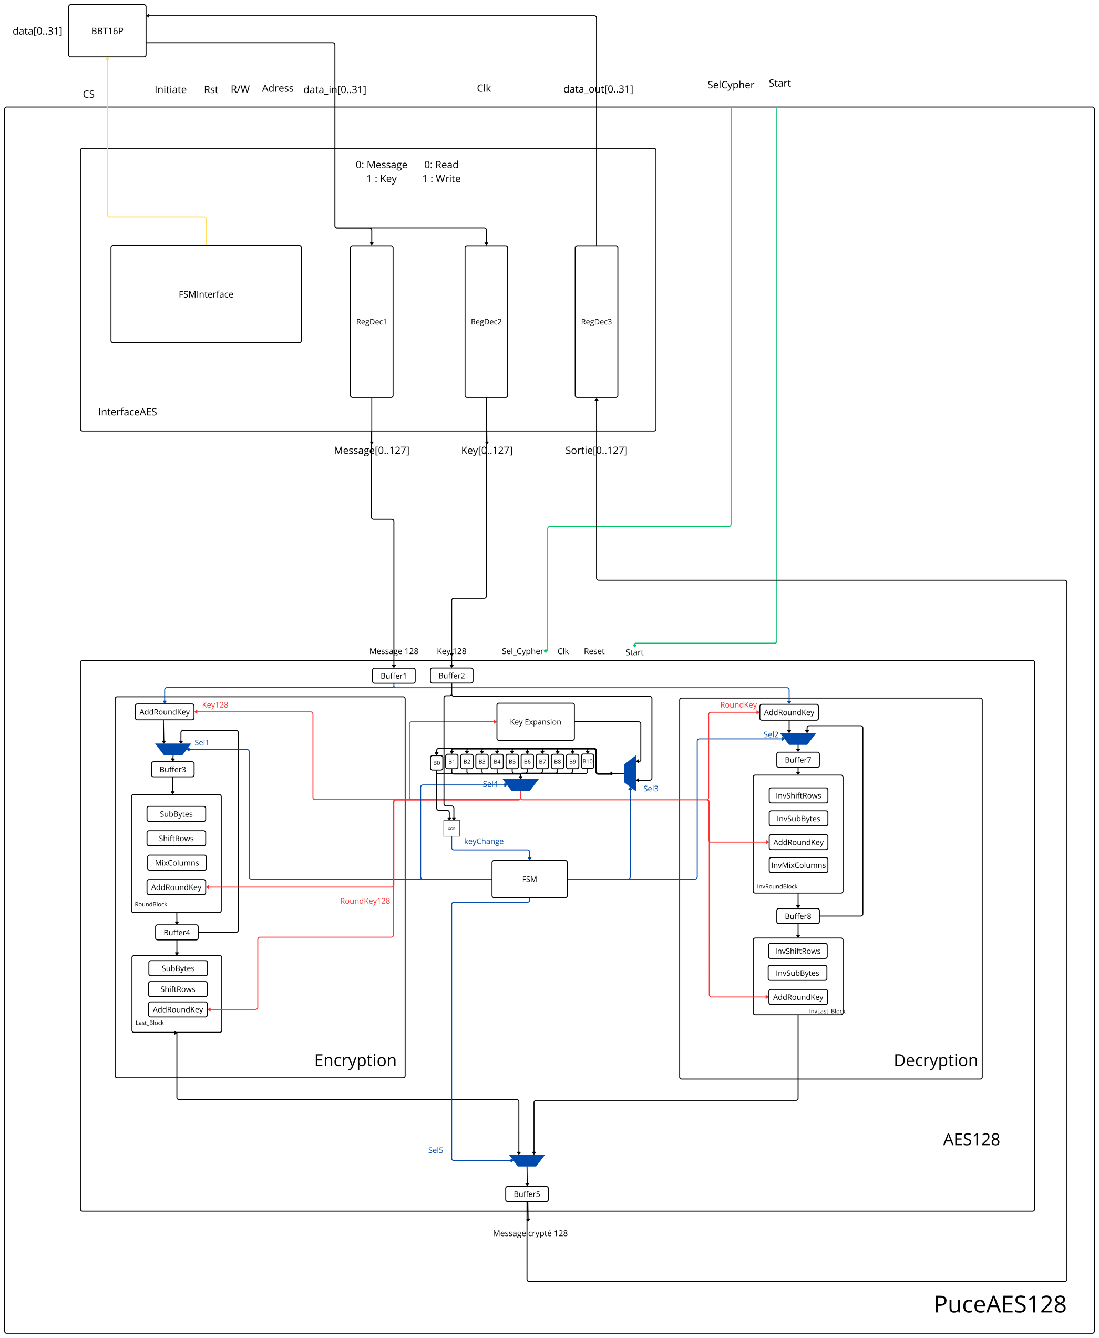
[picture p31: figure]

FIGURE 33 – Schéma complet du circuit réalisé

Algorithme de KeyExpansion

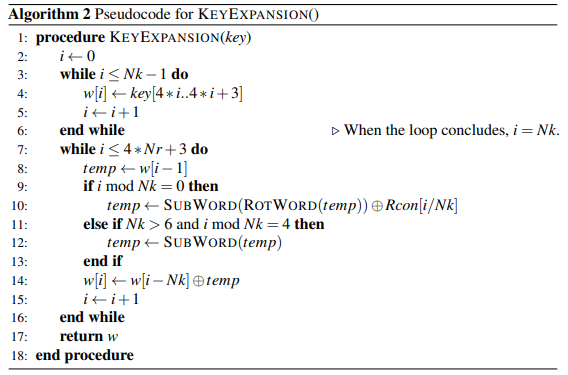
[picture p32: figure]

FIGURE 34 – Algorithme de génération des roundKey

12
