MiniVoitz/AES128_SV/(list of files, cad)

Other CAD files:
work/@a@e@s128/verilog.psm
work/@a@e@s128_tb/verilog.psm
work/@add@round_@key/verilog.psm
work/@add@round_@key_tb/verilog.psm
work/@inv@last@block/verilog.psm
work/@inv@mix@columns/verilog.psm
work/@inv@mix@columns_tb/verilog.psm
work/@inv@round@block/verilog.psm
work/@inv@s@box/verilog.psm
work/@inv@s@box_pkg/verilog.psm
work/@inv@s@box_sv_unit/verilog.psm
work/@inv@s@box_tb/verilog.psm
work/@inv@shift@rows/verilog.psm
work/@inv@shift@rows_tb/verilog.psm
work/@inv@sub@bytes/verilog.psm
work/@inv@sub@bytes_tb/verilog.psm
work/@key@expansion/verilog.psm
work/@key@expansion_tb/verilog.psm
work/@key@expansion_tb_sv_unit/verilog.psm
work/@last@block/verilog.psm
work/@last@block_tb/verilog.psm
work/@mix@columns/verilog.psm
work/@mix@columns_tb/verilog.psm
work/@rcon_pkg/verilog.psm
work/@round@block/verilog.psm
work/@round@block_tb/verilog.psm
work/@s@box/verilog.psm
work/@s@box_pkg/verilog.psm
work/@s@box_pkg2/verilog.psm
work/@s@box_tb/verilog.psm
work/@sbox_sv_unit/verilog.psm
work/@shift@rows/verilog.psm
work/@shift@rows_tb/verilog.psm
work/@sub@bytes/verilog.psm
work/@sub@bytes_tb/verilog.psm
work/buffer/verilog.psm
work/buffer_tb/verilog.psm
work/fsm/verilog.psm
work/fsm_tb/verilog.psm
work/mult11to1/verilog.psm
work/mult2to1/verilog.psm
work/mult2to1_tb/verilog.psm
