MiniVoitz/AES128_SV/(commit log)

2024-03-29 Fixed AES128 loading issues and finished first implementation of fsm
    [AES128.sv, AES128_tb.sv, fsm.sv]
2024-03-29 Fixed some of AES128 issues. Keyexpansion seems to be working. Added the bufferKeys multiplexer. Added .do file for Modelsim. Still to fix : issue with RoundBlockE (probably not the correct RoundKey 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
    [AES128.sv, AES128_tb.sv, KeyExpansion.sv, fsm.sv, mult11to1.sv, mult11to1_tb.sv]
2024-04-01 Successfull test of encryption, still a problem with keyChange.
    [AES128_tb.sv, fsm.sv]
2024-04-04 Fixed shift registers and added testbenchs
    [Shiftregister128to32.sv, Shiftregister128to32_tb.sv, Shiftregister32to128.sv, Shiftregister32to128_tb.sv]
2024-04-05 FIxed what I have broken
    [verilog.psm]
2024-04-05 Added interface and testbench
    [verilog.psm]
2024-04-05 Fixed problem with start
    [AES128.sv, AES128_tb.sv, PuceAES128.sv, PuceAES128_tb.sv, fsm.sv, fsm_tb.sv]
